junhok82/ITEM/item_app_6.18/readme.txt

기기연결까지 완료된 어플에 '원격제어'부분의 이름바꾸기 및 삭제를 도입하기 위함
