junhok82/ITEM/smart_tap/Readme.txt

#-------------스마트 멀티탭-------------#
KmC_fit0703.py
	300주기 동안의 전류값을 샘플링하여 rms 기반의 특성으로 나타내고 엑셀파일(xlsx)로 저장.
	해당 특성은 추후 KmC_analysis0502.py 에서 x, y, z축으로 사용됨.

sendexcel.py
	위의 KmC_fit0703.py에서 생성된 엑셀파일을 AWS 서버로 전송 (TCP/IP)

#--------------AWS 서버--------------#
recvexcel.py
	멀티탭에서 보내준 엑셀파일을 저장 (TCP/IP)
	
KmC_analysis0502.py
	수신한 엑셀파일로 K-means Clustering을 진행하여 기존에 저장했던 기기인지, 새로운 기기인지 판별.
	기존에 저장했던 기기일 경우 측정했던 샘플은 버려지며 새로운 기기일 경우 군집 개수가 증가하고 샘플을 저장함.
