junhok82/ITEM/images/all.png

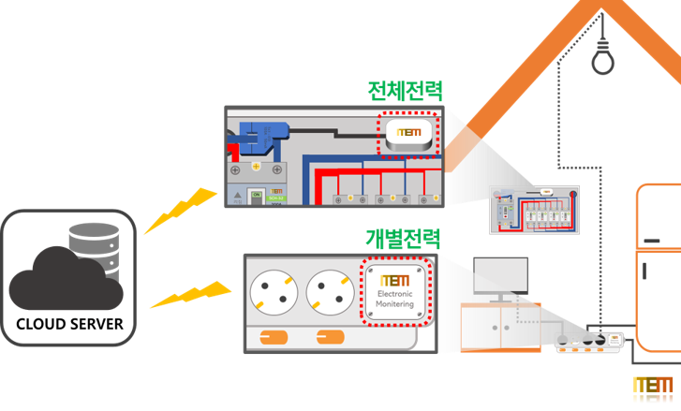
images/all.png
