junhok82/ITEM/images/pushy.png

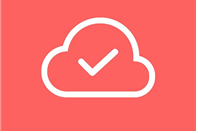
images/pushy.png
